OneTwoN-1/Cricket-Sound-Generator-Analog/Media/Circuit.jpeg

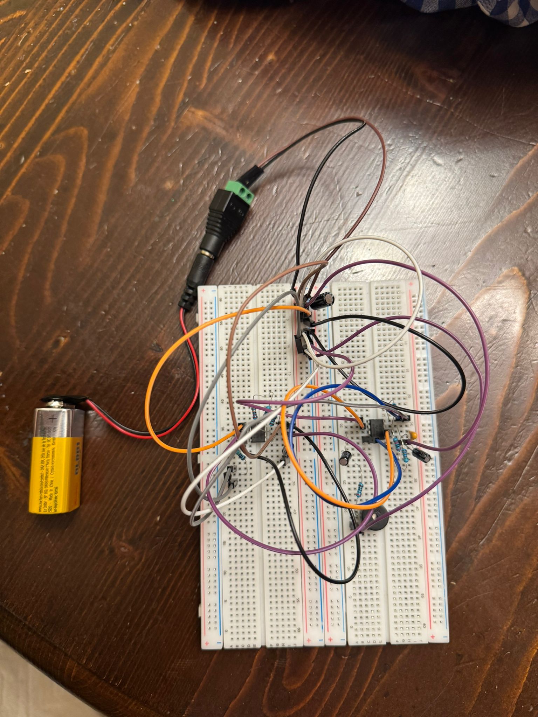
Media/Circuit.jpeg
