OneTwoN-1/Cricket-Sound-Generator-Analog/(list of files, drawings)

Other design files:
Cricket.pdsprj
